PGASlab/app/article/devto-post.md

---
title: "PGAS: an AI nose on the Arduino UNO Q, the modern silver spoon for street-food vendors"
published: false
tags: hacktoberfest, arduino, opensource, ai
---

<!-- SKELETON. Sections will follow the official Week 2 submission template once
     confirmed. Every number below is a placeholder until it is measured and
     logged in the repo. -->

*This is a submission for the [DEV Hacktoberfest 2026 Challenge](https://dev.to/challenges/hf26): Week 2, "Side Hustle".*

## The silver spoon

[SECTION: silver spoon story. Silver tarnishes black on contact with sulfides.
Spoiling food releases ammonia, sulfides and ethanol. PGAS smells them.]

## The problem: a night-market stall at 9 pm

[SECTION: vendor pain points. Selling spoiled food is a safety risk; throwing
out good food is lost money. No lab and no internet at the stall.]

## What I built

[SECTION: PGAS overview. Hood mode, continuous mode, three grades, one line of
advice. Photo of the box.]

## Demo

[DEMO_VIDEO_URL]

## How it works

[SECTION: architecture diagram (from README), sensors, MCU -> Bridge -> Linux,
features, ONNX classifier, Gemma 3 1B via the App Lab llm brick, fallback rules,
LED matrix.]

## Results

[SECTION: real figures only. Spoilage curves, hood fresh vs swill, confusion matrix.]

- Leave-one-session-out accuracy: [ACCURACY_TBD]
- Time from end of capture to advice on the board: [LATENCY_TBD]
- Data: [DATASET_TBD]

## Why open source and offline matter at a street stall

[SECTION: works without signal; data never leaves the stall; zero running
cost; swap the model or retrain on your own food.]

## What I'd do next

[SECTION]

## Team

[TEAM_DEV_HANDLES]

## Prize categories

Best Use of Arduino
