PGASlab/app/docs/bom.md

# Bill of materials

| Qty | Part | Role |
|---|---|---|
| 1 | Arduino UNO Q (ABX00162 2 GB or ABX00173 4 GB) | MCU + Linux, runs everything offline |
| 1 | MQ-135 gas sensor module | ammonia, sulfides (spoiled protein) |
| 1 | Waveshare MQ-3 gas sensor module | ethanol (fermentation) |
| 1 | MQ-2 gas sensor module | broad volatile organic compounds |
| 1 | DHT22 / AM2302 (bare part) | temperature and humidity, used as features |
| 3 | 10 kΩ resistor | divider top, MQ outputs |
| 3 | 20 kΩ resistor | divider bottom, MQ outputs |
| 1 | 10 kΩ resistor | DHT22 data pull-up |
| 1 | K-812 plastic box | sensor enclosure: hood or chamber |
| — | jumper wires, small breadboard | — |
| 1 | USB-C cable | power and data from the Mac |
| 1 | Xiaomi 5000 mAh power bank (5 V ⎓ 3 A USB-C) | portable demos |

Prices are not listed, because they vary by market and nothing was measured. The
software is free and open source, and the running cost is zero: no cloud, no
subscription.
