PGASlab/app/docs/results.md

# Results

Only measured numbers go here. Each one links to the file it came from.

| Metric | Value | Source |
|---|---|---|
| LOSO accuracy | [ACCURACY_TBD] | `models/model_card.json` |
| Capture-to-advice time on the UNO Q | [LATENCY_TBD] | `data/board-logs/` |
| ONNX inference time on the UNO Q | [INFERENCE_MS_TBD] | `data/board-logs/` |
| LLM advice time on the UNO Q | [LLM_S_TBD] | `data/board-logs/` |
| Continuous recordings | [DATASET_TBD] | `data/raw/*_continuous_*.csv` |
| Hood captures | [DATASET_TBD] | `data/raw/*_hood_*.csv` |
