PGASlab/app/(commit log)

2026-10-14 Add README, wiring, BOM, labeling and results docs
    Claude-Session: https://claude.ai/code/session_01JysRQznd2jXkmrMFHmPaQm
2026-10-16 Add circuit simulation: Wokwi project and simavr end-to-end run
    The sketch gains an AVR branch (Uno R3 stand-in) that replaces Bridge and the
    LED matrix with Serial and rescales readings to the UNO Q's 14-bit / 3.3 V
    scale. A simavr board model provides the 10k/20k dividers and a timing-level
    DHT22; sim/run_sim.py connects it to the real Linux-side app and CLI. CI
    builds the firmware with the official Arduino AVR core and runs both.
    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
2026-10-16 Add PGAS logo and in-browser circuit simulation
    assets/pgas-org-logo.png is the PGASlab organisation avatar (fixes the broken
    README image). sim/web/pgas-circuit-sim.html runs the real firmware in avr8js
    with the PGAS wiring, live divider voltages, a DHT22 model, the serial monitor
    and a hood-mode LED-matrix run; it is self-contained and works offline.
    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
2026-10-16 Add UNO Q software-in-the-loop simulation; impute missing DHT22 values
    sim/unoq/hal emulates the UNO Q MCU API the sketch uses (14-bit ADC on 3.3 V,
    GPIO with a microsecond virtual clock, Bridge provide/notify, the 8x13
    Arduino_LED_Matrix) plus the PGAS wiring. The sketch's UNO Q code path is
    compiled natively (driven by the real Python app in CI via sim/run_sim.py
    --unoq) and to WebAssembly for sim/web/pgas-unoq-sim.html, which shows the
    board's LED matrix drawn by the sketch through Bridge.call("draw").
    The simulation exposed that a capture with no valid DHT22 reading crashed the
    classifier ('missing features'). Temperature/humidity are now filled with the
    training medians stored in model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
2026-10-16 UNO Q sim page: pure-JS MCU build, phone layout, hosted-page variant
    sim/unoq/build.sh js compiles the same MCU code to plain JavaScript for hosts
    that do not allow WebAssembly; sim/web/make_artifact.py strips the document
    skeleton for hosted pages. The wiring diagram scrolls instead of shrinking on
    narrow screens.
    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
2026-10-16 Simulation page: plain-language first screen, circuit kept below
    The top now shows the board's LED screen large, two sample buttons, the three
    hood steps with countdowns and a smell-strength meter with a one-line verdict.
    The live circuit stays as 'Inside the box'; sliders, raw readings and Bridge
    traffic move into a collapsible engineer view.
    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
2026-10-16 Simulation page: English / Traditional Chinese language switch
    A two-button switch in the top bar changes every visible label, the step
    countdowns, the smell meter and the verdict. The choice is remembered per
    browser; first visit follows the browser language (zh-* opens in Chinese).
    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
2026-10-16 One 'Test freshness' button; every step asks for a re-test on missing data
    Board (pgas/session.py): each hood step validates every reading. No reading for
    5 s, or a gas channel below 1 % of full scale (sensor not detected), raises
    RetestError naming the step; the app logs RETEST, shows E on the LED matrix and
    marks the job result retest=true. Full-scale readings are a strong smell, not a
    fault, and are still accepted.
    Simulation page: the two sample buttons become one 'Test freshness' button
    (each run picks a simulated sample at random). Each step's handler runs in
    try/catch and a 3 s watchdog covers a silent MCU; either stops the test, marks
    the step red and opens a 'Please re-test' dialog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
2026-10-16 Sim page: don't count a background-tab pause against the no-data watchdog
    Animation frames stop while the tab is hidden, and the emulated MCU stops with
    them, so the first frame back saw a multi-second gap and raised a false
    'Please re-test'. A frame gap over 1 s now moves the watchdog's last-sample
    time forward by the gap. Also use FULL14 for the sensor-detected floor.
    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
2026-10-16 Add live Wi-Fi dashboard served by the board (arduino:web_ui brick)
    - app.yaml: add the arduino:web_ui brick next to arduino:llm (port 7000).
    - pgas/web.py: LiveFeed pushes each 1 Hz sample (module volts, raw counts,
    DHT22, current job) plus job log lines and the grade over Socket.IO, and
    sends the last 5 minutes to a newly connected browser. Never raises.
    - Runtime takes an optional feed; main.py wires WebUI -> LiveFeed and keeps
    running without the brick.
    - app/assets: mobile-first page with 4 live tiles, hand-drawn 5-minute
    canvas charts, a 3 s no-data warning and an English / Traditional Chinese
    toggle. The Socket.IO client and arduino.js ship in assets/libs as in the
    officia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
2026-10-16 Fix on-board build: add Bridge libraries to sketch profile, drop missing llm brick
    The sketch failed to compile on the UNO Q (MsgPack.h not found) because
    sketch.yaml listed no libraries; use the FQBN and library set from the
    App Lab examples on the board. The installed App Lab has no arduino:llm
    brick, so the app refused to start; the agent already falls back to
    rule-based advice without it.
    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
2026-10-16 deploy over adb: reset TMPDIR so arduino-app-cli can start the app
    adb shell exports TMPDIR=/data/local/tmp, which does not exist on the UNO Q;
    arduino-app-cli app start then failed with 'stat /data/local/tmp: no such file
    or directory' after the sketch libraries were installed.
    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
2026-10-18 Dashboard: start a hood test, self-test or stop from the phone
    The dashboard gets a 'Test food' panel: food name + condition (fresh,
    spoiling, spoiled, swill, test) build the hood label, and Start test /
    Self-test / Stop send a pgas_command over the web_ui socket. main.py
    queues it through the same job files as python -m pgas.capture, so the
    run, the LED matrix prompts and the saved CSV are identical; the reply
    and the job's progress come back to the page. Input is validated on both
    sides (ASCII food name, known condition). Tested with unit tests and an
    end-to-end run on the fake board.
    Claude-Session: https://claude.ai/code/session_01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
2026-10-18 Dashboard: one Test freshness button with progress bar and result pop-up
    - One button replaces the food name / condition form; it queues a hood
    test labelled "check" (not used for training).
    - run_hood reports progress once per second; the feed forwards it and the
    page shows a progress bar with the current A/M/H/V instruction.
    - Without a trained model, pipeline.analyze grades with a provisional rule
    on the three MQ sensors only (pgas/rules.py: largest rise above the
    clean-air baseline, 0.10 V spoiling / 0.20 V spoiled); the DHT22 is not
    used. The result is shown as an animated pop-up: food looks fine / has
    gone bad / please test again.
    - Footer disclaimer (EN / 繁中).
    Co-Auth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
2026-10-18 Dashboard: guided bag test, one gas sensor at a time
    The food sits in a small sealed bag that fits one MQ module, so the test
    now runs the sensors in turn (new 'bag' job, pgas.session.run_bag): for
    each sensor 3 s of clean air outside the bag, 3 s to put it in, 5 s
    measuring; between sensors the page asks the user to swap sensors and
    press 'Ready - test MQ-x' (pgas_command next -> Runtime.press_next; a 5
    min wait without it asks for a re-test). The rise of each sensor in the
    bag over its own clean-air reading feeds the provisional rule in
    pgas/rules.py. The page shows a three-step tracker, the current
    instruction, a progress bar, Cancel, and the result pop-up with the three
    rises. Bag captur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
2026-10-18 Dashboard redesign: Apple-style layout, speedometer gauges, big countdown ring
    - System font, large centred title, soft cards, frosted sticky nav with a
    live pill and EN/中文 segmented control; light and dark themes.
    - Each MQ sensor gets a speedometer dial: the needle shows the rise above
    clean air (0 to +0.5 V) over green / amber / red zones matching
    pgas/rules.py (0.10 / 0.20 V), with a springy needle and a tweened number.
    The normal range is shown under it. Above +0.20 V the card turns red and
    the reading grows and blinks, like a speeding warning.
    - Clean air is the sensor's own clean-air step during a test, otherwise the
    10th percentile of the last minutes.
    - The guided te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
2026-10-18 Bag test: 5 s per sensor; deploy retries a failed MCU flash once
    - run_bag defaults to 1 s clean air, 1 s into the bag, 3 s measuring per
    sensor (was 3 + 3 + 5 s); the dashboard progress shares and help text
    follow.
    - scripts/deploy.sh: arduino-app-cli app start sometimes fails to flash the
    MCU with 'Error requesting gpio line swdio' right after the app stops;
    wait 3 s after stopping and retry the start once after 10 s.
    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
2026-10-18 Do not reject a low but working MQ sensor as unplugged
    On the real board (on a power bank) the Waveshare MQ-3 read 0.04-0.06 V in
    clean air, about 130 raw counts, below the 1 % 'sensor not detected' floor
    (164 counts), so every guided test stopped at MQ-135's clean-air step with
    'MQ3 on A1 reads 132.0 - sensor not detected'. An unplugged AO is pulled to
    0 V by the divider, so lower the floor to 0.25 % (41 counts) in the
    session check and the self-test, with regression tests for both cases.
    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
2026-10-18 Agent loop: sense -> decide on-device -> act; keep the test button on screen
    - Bag test result now runs an explicit agent loop: SENSE (three gas rises),
    DECIDE on the UNO Q (timed, ms) and ACT physically: the LED matrix flashes
    the warning icon three times for a spoiled verdict (shows the tick when
    fresh) and an alert is sent through pgas.notify (queued when Telegram is
    not configured). decide_ms and the actions reach the dashboard.
    - Result sheet shows the Sense / Decide / Act steps.
    - The Start / Next button sits in a sticky bar at the bottom of the screen,
    and the countdown ring is smaller, so the button stays visible on a phone
    while the 2nd and 3rd sensors are tested.
    Co-Au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
2026-10-18 Competition article draft; DHT22 shown as optional on the dashboard
    - docs/article.md: DEV article for the Best Use of Arduino prize. Only real
    board readings (self-test, spoiled milk from the live chart, marked
    approximate); placeholders for the video, screenshots and the fresh vs
    spoiled result table.
    - Dashboard: a missing DHT22 is shown as a neutral 'not connected
    (optional)' note instead of a red error; the verdict uses only the gas
    sensors.
    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
2026-10-18 Board keep-alive: restart PGAS within a minute if a reset leaves it stopped
    On the real board the app was sometimes 'stopped' after a reset (App Lab's
    autostart did not bring it back), so the dashboard refused connections.
    app/keepalive.sh runs every minute from the arduino user's crontab
    (installed by deploy.sh --boot, no sudo needed): after 90 s of uptime, if
    user:pgas is not running and no start is in progress, it starts it and logs
    to /tmp/pgas-keepalive.log. deploy.sh holds /tmp/pgas-deploying while it
    restarts the app so the two never flash the MCU at the same time.
    Claude-Session: https://claude.ai/code/session_01JysRQznd2jXkmrM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
2026-10-18 Dashboard: never reuse a stale clean-air level; article follows the Side Hustle template
    The gauge's clean-air level kept a test's baseline after the test, so after
    holding a sensor near food it could read e.g. 'clean air 0.73 V' and show a
    negative rise. Use the test baseline only while a test runs, and never let
    the rolling level sit above the current reading.
    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
2026-10-18 On-board ONNX model for the guided test, with the rule as a safety net
    A scikit-learn logistic regression on the three gas rises, trained on the
    real tests (clean-air control, two spoiled-milk tests) with noise at the
    measured sensor spread, exported to ONNX and run by ONNX Runtime on the
    UNO Q. The more severe of model and rule wins. The dashboard shows the
    model's spoiled probability.
    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
2026-10-18 Photos: blur only the last two octets of the board's address
    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
2026-10-24 docs: record PGAS Arduino award
    Record the team award with public sources. README only; existing content and contributor credits preserved.
